psu-epl/plastic-scanner/PCB2/symbol_and_footprints/IC_Analog Devices_ADR03ARZ-REEL7/eec.models/Analog_Devices_-_ADR03ARZ-REEL7.step

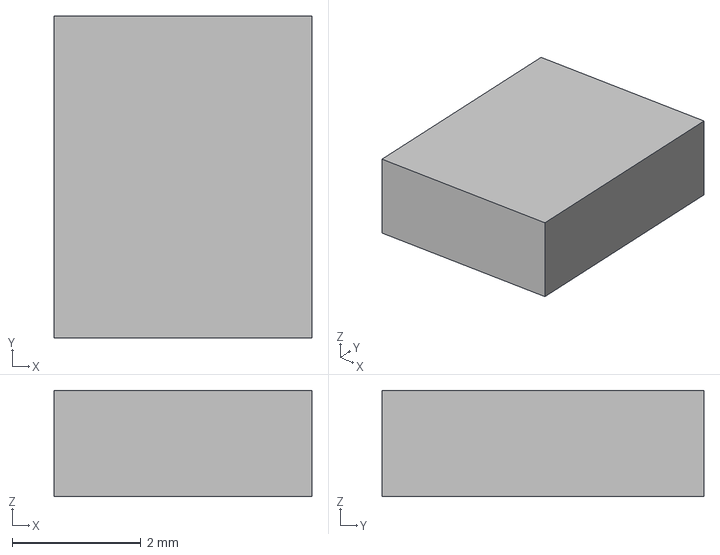
[picture p1: CAD file, 2025-05-15]
PCB2/symbol_and_footprints/IC_Analog Devices_ADR03ARZ-REEL7/eec.models/Analog_Devices_-_ADR03ARZ-REEL7.step
4.00 x 5.00 x 1.65 mm
