psu-epl/plastic-scanner/PCB2/symbol_and_footprints/IC_Nuvoton_NAU7802SGI/eec.models/Nuvoton_-_NAU7802SGI.step

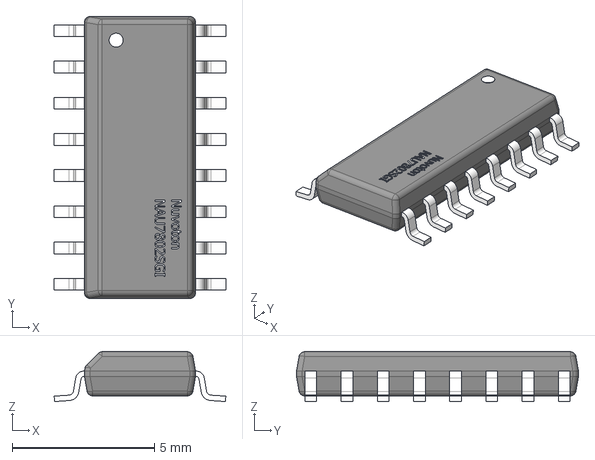
[picture p2: CAD file, 2025-05-15]
PCB2/symbol_and_footprints/IC_Nuvoton_NAU7802SGI/eec.models/Nuvoton_-_NAU7802SGI.step
6.03 x 9.90 x 1.76 mm
