psu-epl/plastic-scanner/PCB2/symbol_and_footprints/IC_Texas Instruments_ADS1256IDBT/eec.models/Texas_Instruments_-_ADS1256IDBT.step

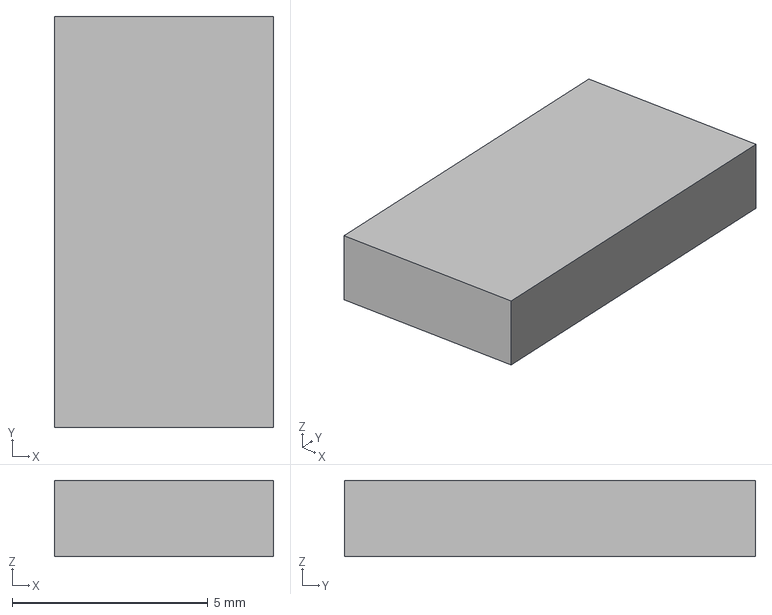
[picture p3: CAD file, 2025-05-15]
PCB2/symbol_and_footprints/IC_Texas Instruments_ADS1256IDBT/eec.models/Texas_Instruments_-_ADS1256IDBT.step
5.60 x 10.5 x 1.95 mm
