psu-epl/plastic-scanner/PCB2/symbol_and_footprints/LP5951MFX-1.8_NOPB/LP5951MFX-1.8_NOPB.step

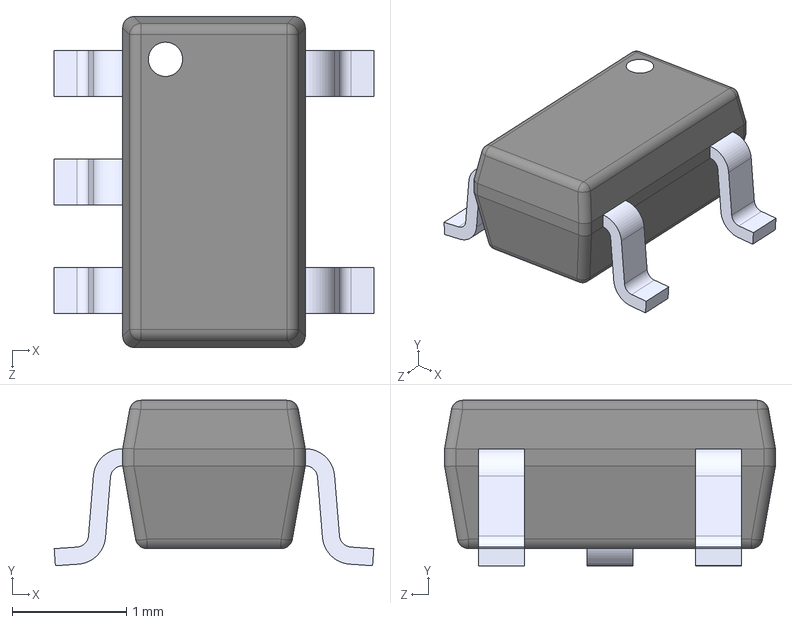
[picture p4: CAD file, 2025-05-15]
PCB2/symbol_and_footprints/LP5951MFX-1.8_NOPB/LP5951MFX-1.8_NOPB.step
2.80 x 1.45 x 2.90 mm
