psu-epl/plastic-scanner/PCB2/symbol_and_footprints/OPA2376AID/OPA2376AID.step

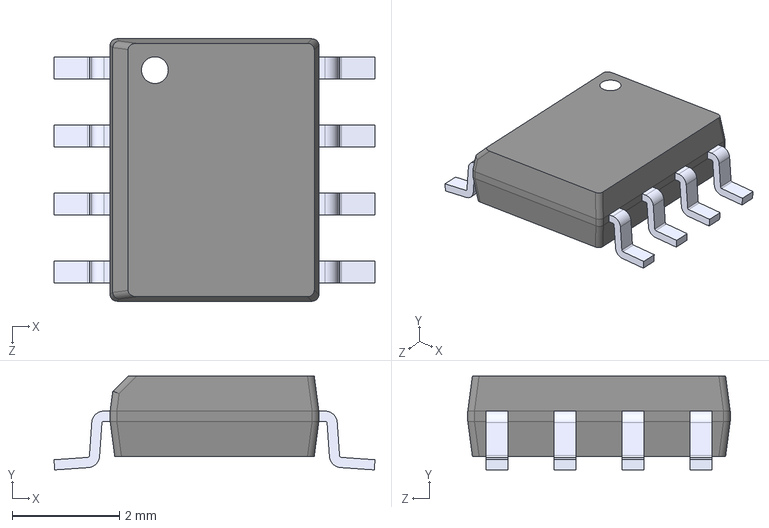
[picture p5: CAD file, 2025-05-15]
PCB2/symbol_and_footprints/OPA2376AID/OPA2376AID.step
5.99 x 1.75 x 4.90 mm
