psu-epl/plastic-scanner/PCB2/symbol_and_footprints/TLC59108IPWR.step

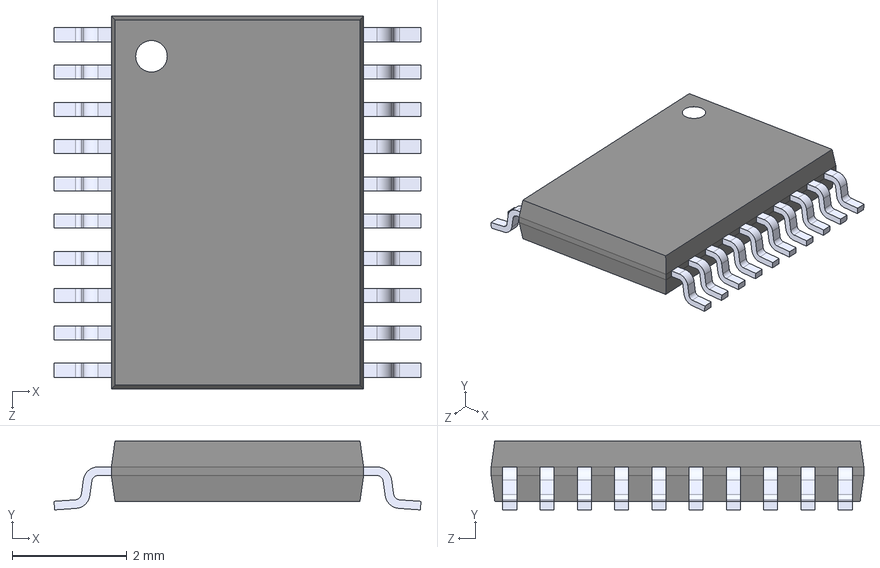
[picture p6: CAD file, 2025-05-15]
PCB2/symbol_and_footprints/TLC59108IPWR.step
6.40 x 1.20 x 6.50 mm
