psu-epl/plastic-scanner/PCB2/PCB KiCad.kicad_pcb

## KiCad design PCB2/PCB KiCad.kicad_pcb (2025-05-23)

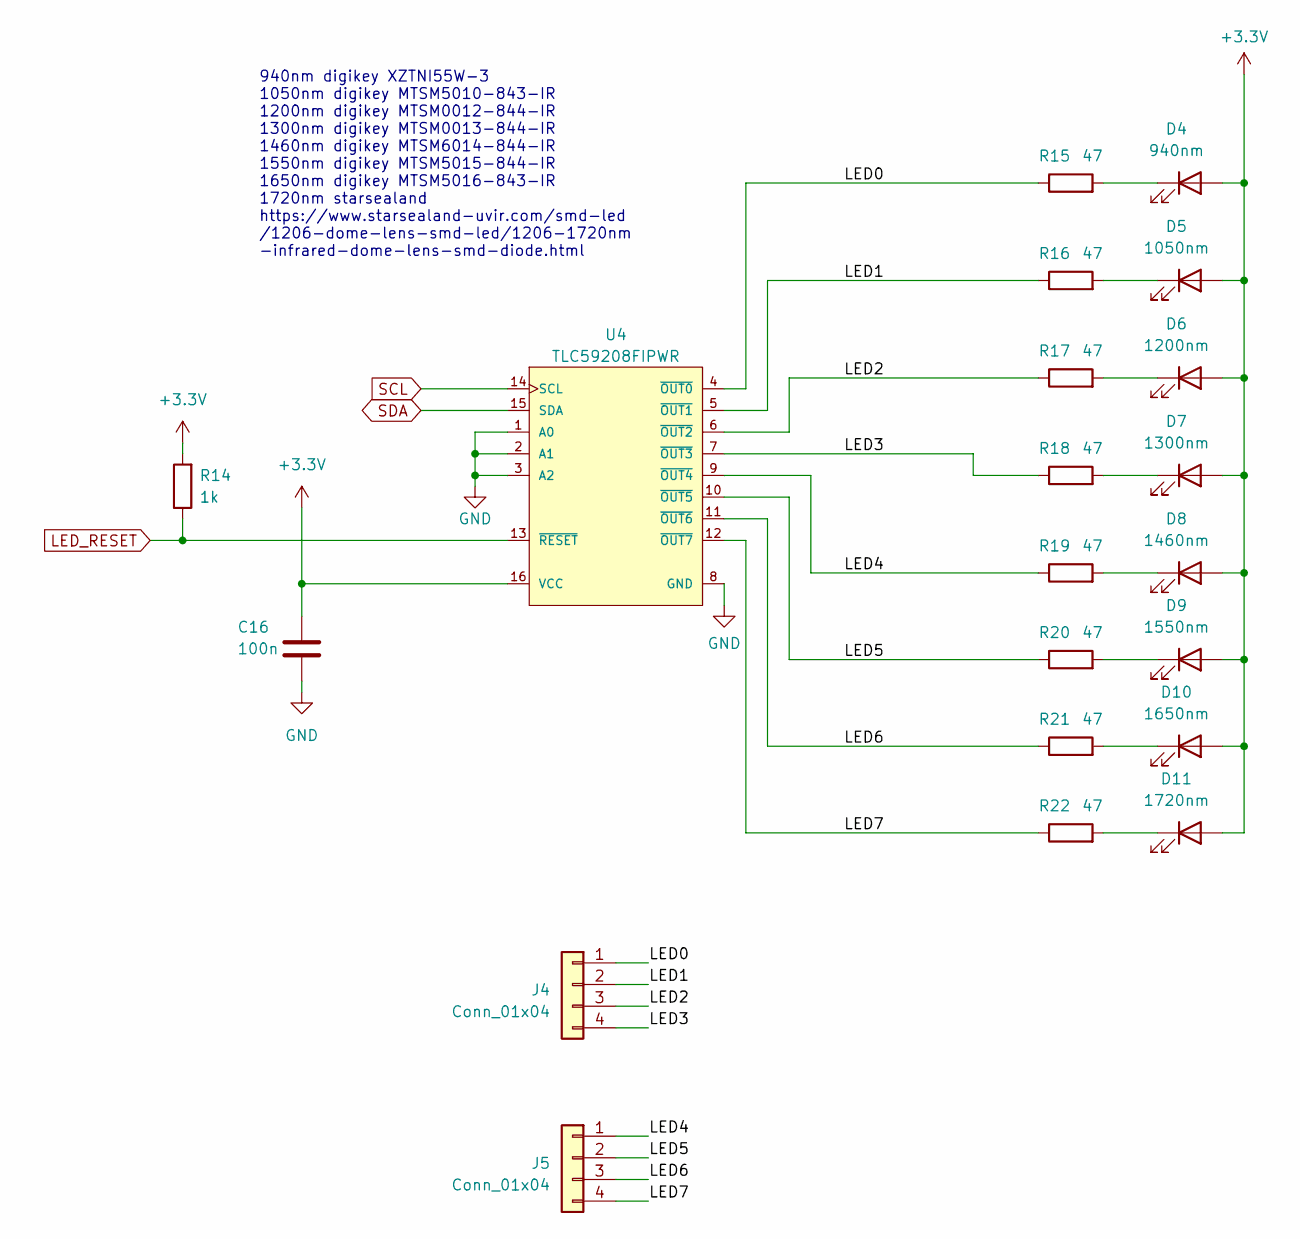
[picture p7: schematic led.kicad_sch, Development Board]

Parts:
C16: 100n; C_0805_2012Metric_Pad1.18x1.45mm_HandSolder
D4: 940nm; LED_1206_3216Metric_Pad1.42x1.75mm_HandSolder
D5: 1050nm; LED_1206_3216Metric_Pad1.42x1.75mm_HandSolder
D6: 1200nm; LED_1206_3216Metric_Pad1.42x1.75mm_HandSolder
D7: 1300nm; LED_1206_3216Metric_Pad1.42x1.75mm_HandSolder
D8: 1460nm; LED_1206_3216Metric_Pad1.42x1.75mm_HandSolder
D9: 1550nm; LED_1206_3216Metric_Pad1.42x1.75mm_HandSolder
D10: 1650nm; LED_1206_3216Metric_Pad1.42x1.75mm_HandSolder
D11: 1720nm; LED_1206_3216Metric_Pad1.42x1.75mm_HandSolder
J4, J5: Conn_01x04; PinSocket_1x04_P2.54mm_Vertical
R14: 1k; R_0805_2012Metric_Pad1.20x1.40mm_HandSolder
R15, R16, R17, R18, R19, R20, R21, R22: 47; R_0805_2012Metric_Pad1.20x1.40mm_HandSolder
U4: TLC59208FIPWR; Texas_Instruments-TLC59208FIPWR-Level_A

Connections:
+3.3V: C16.1, D4.2 (A), D5.2 (A), D6.2 (A), D7.2 (A), D8.2 (A), D9.2 (A), D10.2 (A), D11.2 (A), R14.2, U4.16 (VCC); also elsewhere on the board
/LED/LED0: J4.1, R15.1, U4.4 (~OUT0)
/LED/LED1: J4.2, R16.1, U4.5 (~OUT1)
/LED/LED2: J4.3, R17.1, U4.6 (~OUT2)
/LED/LED3: J4.4, R18.1, U4.7 (~OUT3)
/LED/LED4: J5.1, R19.1, U4.9 (~OUT4)
/LED/LED5: J5.2, R20.1, U4.10 (~OUT5)
/LED/LED6: J5.3, R21.1, U4.11 (~OUT6)
/LED/LED7: J5.4, R22.1, U4.12 (~OUT7)
GND: C16.2, U4.1 (A0), U4.2 (A1), U4.3 (A2), U4.8 (GND); also elsewhere on the board
LED_RESET: R14.1, U4.13 (~RESET); also elsewhere on the board
unnamed: D4.1 (K), R15.2
unnamed: D5.1 (K), R16.2
unnamed: D6.1 (K), R17.2
unnamed: D7.1 (K), R18.2
unnamed: D8.1 (K), R19.2
unnamed: D9.1 (K), R20.2
unnamed: D10.1 (K), R21.2
unnamed: D11.1 (K), R22.2
SCL: U4.14 (SCL); also elsewhere on the board
SDA: U4.15 (SDA); also elsewhere on the board

Notes on the sheet:
940nm digikey XZTNI55W-3 1050nm digikey MTSM5010-843-IR 1200nm digikey MTSM0012-844-IR 1300nm digikey MTSM0013-844-IR 1460nm digikey MTSM6014-844-IR 1550nm digikey MTSM5015-844-IR 1650nm digikey MTSM5016-843-IR 1720nm starsealand https://www.starsealand-uvir.com/smd-led /1206-dome-lens-smd-led/1206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

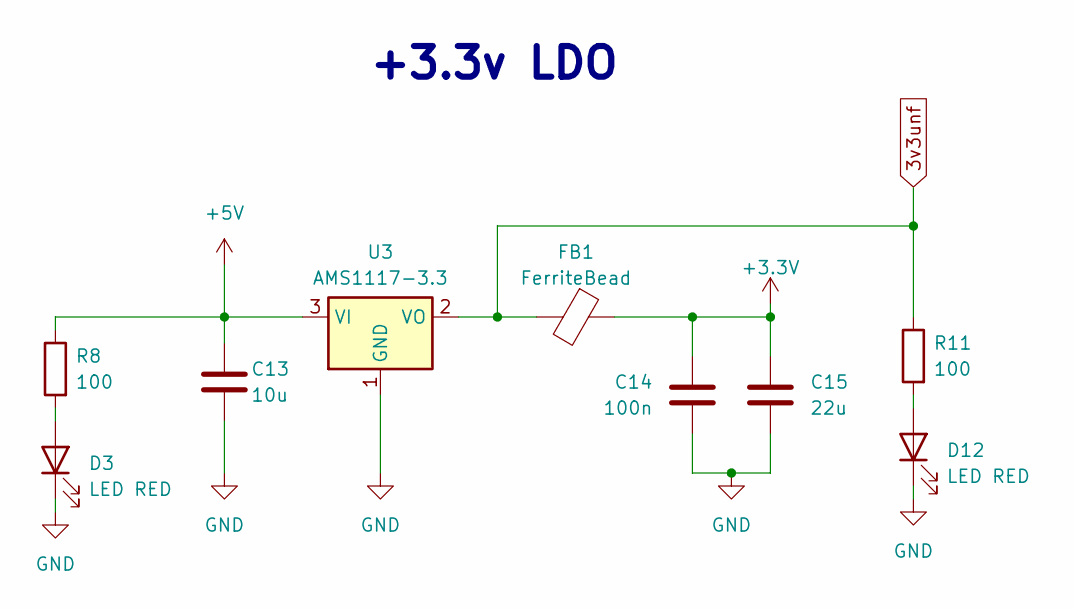
[picture p8: schematic power.kicad_sch, Development Board]

Parts:
C13: 10u; C_0805_2012Metric_Pad1.18x1.45mm_HandSolder
C14: 100n; C_0805_2012Metric_Pad1.18x1.45mm_HandSolder
C15: 22u; C_0805_2012Metric_Pad1.18x1.45mm_HandSolder
D3, D12: LED RED; LED_0805_2012Metric_Pad1.15x1.40mm_HandSolder
FB1: FerriteBead; R_0805_2012Metric_Pad1.20x1.40mm_HandSolder
R8, R11: 100; R_0805_2012Metric_Pad1.20x1.40mm_HandSolder
U3: AMS1117-3.3; SOT-223-3_TabPin2

Connections:
3v3unf: FB1.2, R11.1, U3.2 (VO); also elsewhere on the board
+3.3V: C14.2, C15.1, FB1.1; also elsewhere on the board
+5V: C13.1, R8.1, U3.3 (VI); also elsewhere on the board
GND: C13.2, C14.1, C15.2, D3.1 (K), D12.1 (K), U3.1 (GND); also elsewhere on the board
unnamed: D3.2 (A), R8.2
unnamed: D12.2 (A), R11.2

Notes on the sheet:
+3.3v LDO

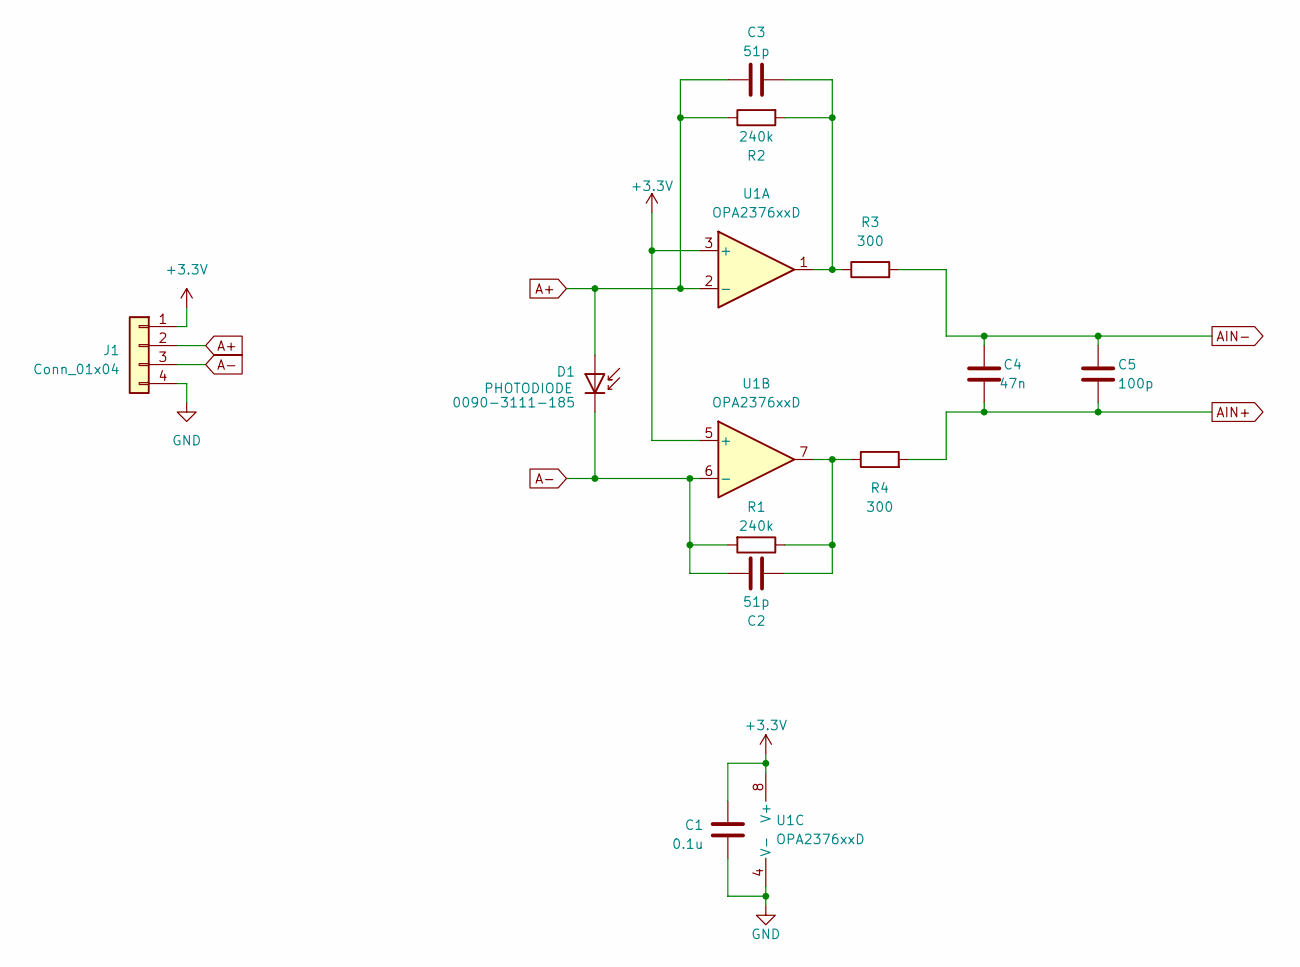
[picture p9: schematic sensor.kicad_sch, Development Board]

Parts:
C1: 0.1u; C_0805_2012Metric_Pad1.18x1.45mm_HandSolder
C2, C3: 51p; C_0805_2012Metric_Pad1.18x1.45mm_HandSolder
C4: 47n; C_0805_2012Metric_Pad1.18x1.45mm_HandSolder
C5: 100p; C_0805_2012Metric_Pad1.18x1.45mm_HandSolder
D1: 0090-3111-185; D_1206_3216Metric_Pad1.42x1.75mm_HandSolder
J1: Conn_01x04; PinSocket_1x04_P2.54mm_Vertical
R1, R2: 240k; R_0805_2012Metric_Pad1.20x1.40mm_HandSolder
R3, R4: 300; R_0805_2012Metric_Pad1.20x1.40mm_HandSolder
U1: OPA2376xxD; SOIC127P599X175-8N

Connections:
+3.3V: C1.2, J1.1, U1.3 (+), U1.5 (+), U1.8 (V+); also elsewhere on the board
A+: C3.1, D1.2 (A), J1.2, R2.1, U1.2 (-)
A-: C2.1, D1.1 (K), J1.3, R1.2, U1.6 (-)
AIN+: C4.1, C5.2, R4.2; also elsewhere on the board
AIN-: C4.2, C5.1, R3.2; also elsewhere on the board
GND: C1.1, J1.4, U1.4 (V-); also elsewhere on the board
unnamed: C2.2, R1.1, R4.1, U1.7
unnamed: C3.2, R2.2, R3.1, U1.1

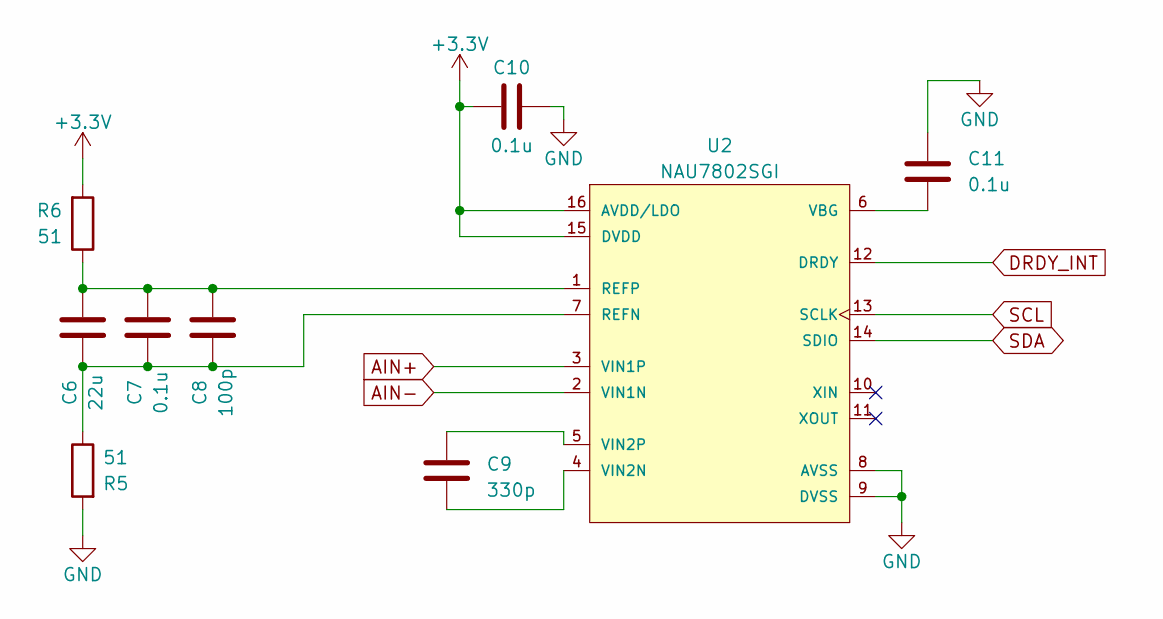
[picture p10: schematic adc.kicad_sch, Development Board]

Parts:
C6: 22u; C_0805_2012Metric_Pad1.18x1.45mm_HandSolder
C7, C10, C11: 0.1u; C_0805_2012Metric_Pad1.18x1.45mm_HandSolder
C8: 100p; C_0805_2012Metric_Pad1.18x1.45mm_HandSolder
C9: 330p; C_0805_2012Metric_Pad1.18x1.45mm_HandSolder
R5, R6: 51; R_0805_2012Metric_Pad1.20x1.40mm_HandSolder
U2: NAU7802SGI; Nuvoton-NAU7802SGI-0-0-0; digikey description IC ADC 24BIT I2C/SRL 16-SOP

Connections:
+3.3V: C10.1, R6.2, U2.15 (DVDD), U2.16 (AVDD/LDO); also elsewhere on the board
AIN+: U2.3 (VIN1P); also elsewhere on the board
AIN-: U2.2 (VIN1N); also elsewhere on the board
DRDY_INT: U2.12 (DRDY); also elsewhere on the board
GND: C10.2, C11.1, R5.2, U2.8 (AVSS), U2.9 (DVSS); also elsewhere on the board
unnamed: C6.1, C7.1, C8.1, R5.1, U2.7 (REFN)
unnamed: C6.2, C7.2, C8.2, R6.1, U2.1 (REFP)
unnamed: C11.2, U2.6 (VBG)
unnamed: C9.2, U2.4 (VIN2N)
unnamed: C9.1, U2.5 (VIN2P)
SCL: U2.13 (SCLK); also elsewhere on the board
SDA: U2.14 (SDIO); also elsewhere on the board

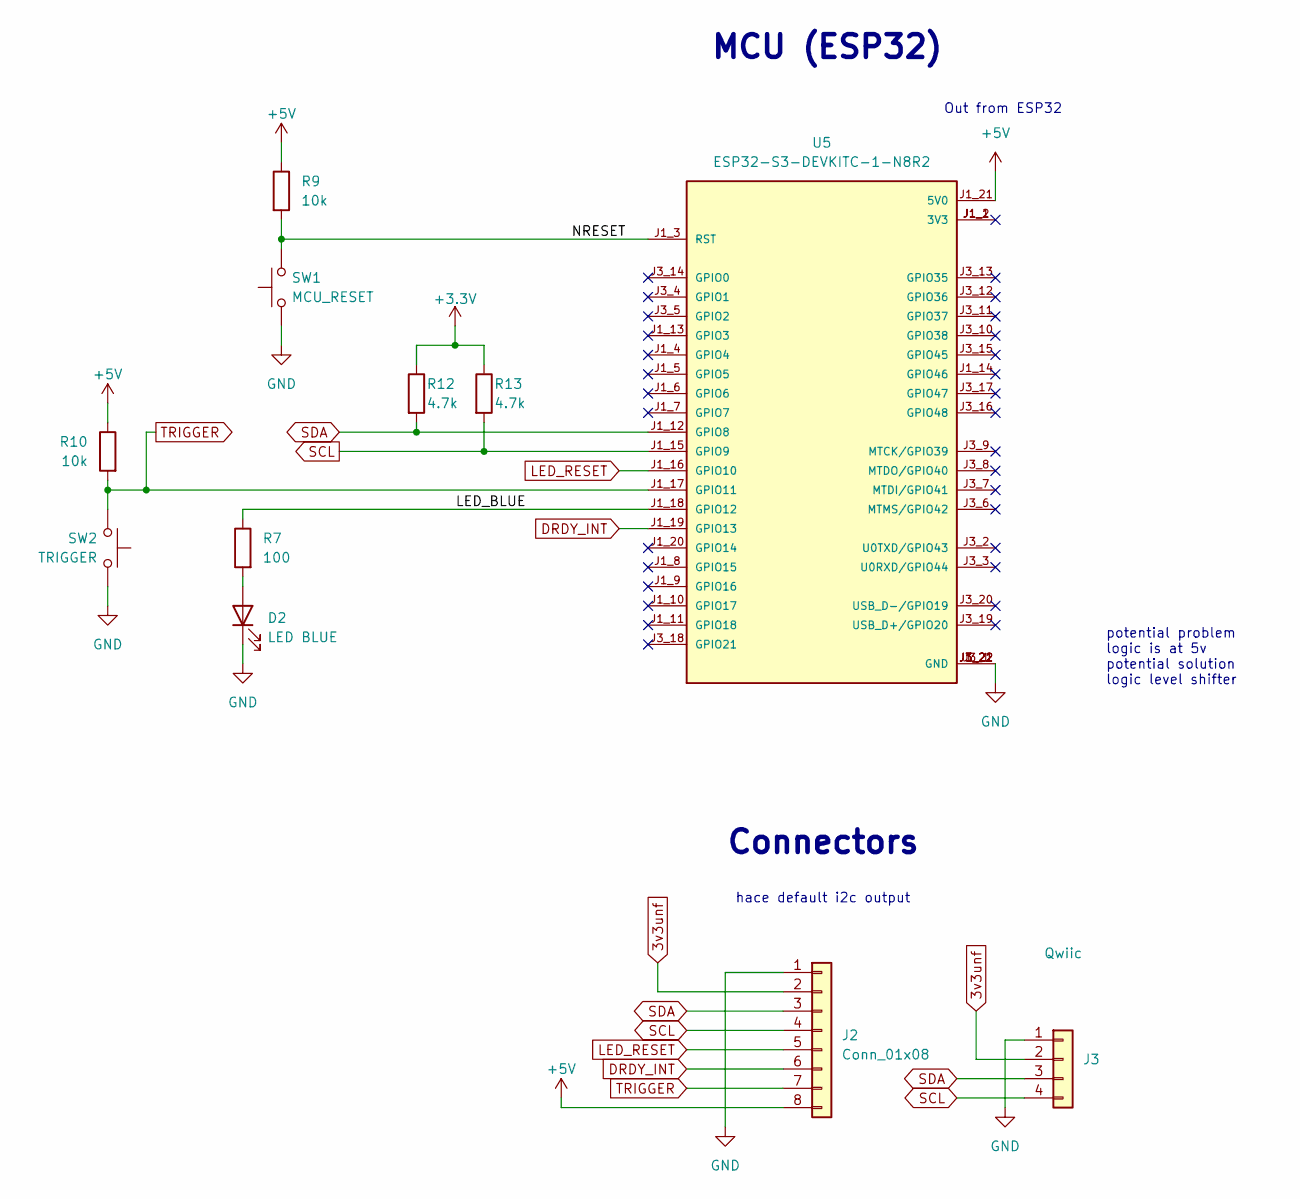
[picture p11: schematic mcu.kicad_sch, Development Board]

Parts:
D2: LED BLUE; LED_0805_2012Metric_Pad1.15x1.40mm_HandSolder
J2: Conn_01x08; PinHeader_1x08_P2.54mm_Vertical
J3: Qwiic; JST_SH_SM04B-SRSS-TB_1x04-1MP_P1.00mm_Horizontal
R7: 100; R_0805_2012Metric_Pad1.20x1.40mm_HandSolder
R9, R10: 10k; R_0805_2012Metric_Pad1.20x1.40mm_HandSolder
R12, R13: 4.7k; R_0805_2012Metric_Pad1.20x1.40mm_HandSolder
SW1: MCU_RESET; SW_PUSH_6mm
SW2: TRIGGER; SW_PUSH_6mm
U5: ESP32-S3-DEVKITC-1-N8R2; XCVR_ESP32-S3-DEVKITC-1-N8R2; PARTREV V1

Connections:
3v3unf: J2.2, J3.2; also elsewhere on the board
+3.3V: R12.1, R13.1; also elsewhere on the board
+5V: J2.8, R9.1, R10.1, U5.J1_21 (5V0); also elsewhere on the board
/MCU + IO/LED_BLUE: R7.1, U5.J1_18 (GPIO12)
/MCU + IO/NRESET: R9.2, SW1.2, U5.J1_3 (RST)
DRDY_INT: J2.6, U5.J1_19 (GPIO13); also elsewhere on the board
GND: D2.1 (K), J2.1, J3.1, SW1.1, SW2.1, U5.J1_22 (GND), U5.J3_1 (GND), U5.J3_21 (GND), U5.J3_22 (GND); also elsewhere on the board
LED_RESET: J2.5, U5.J1_16 (GPIO10); also elsewhere on the board
unnamed: D2.2 (A), R7.2
SCL: J2.4, J3.4, R13.2, U5.J1_15 (GPIO9); also elsewhere on the board
SDA: J2.3, J3.3, R12.2, U5.J1_12 (GPIO8); also elsewhere on the board
TRIGGER: J2.7, R10.2, SW2.2, U5.J1_17 (GPIO11)

Notes on the sheet:
MCU (ESP32)
potential problem logic is at 5v potential solution logic level shifter
Out from ESP32
hace default i2c output
Connectors

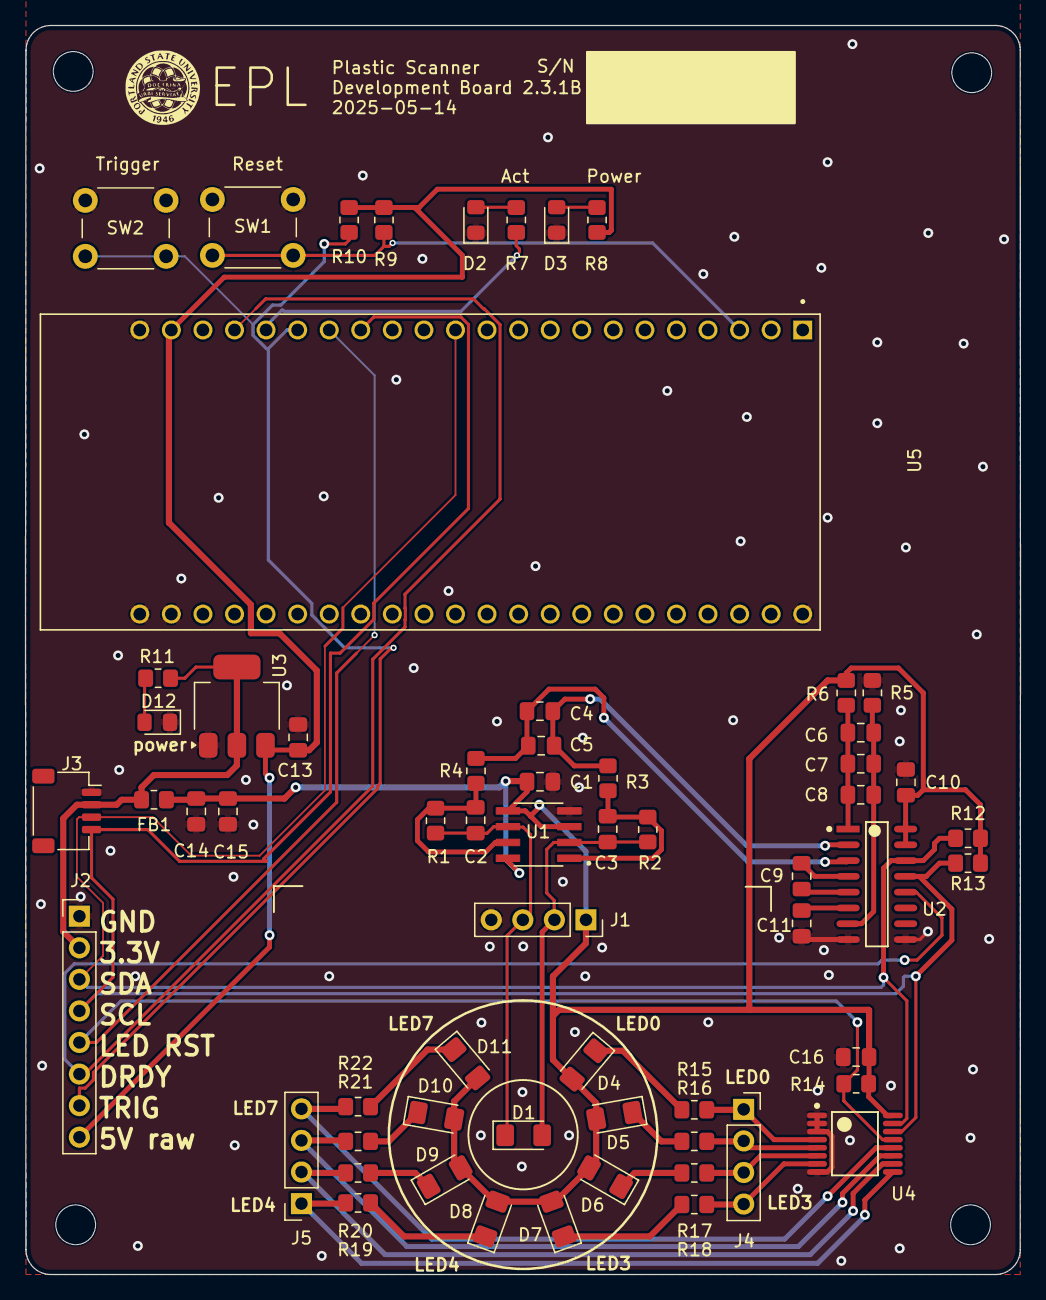
[picture p12: board PCB KiCad.kicad_pcb from above]

Board: 2 copper layers, 80.1 x 100.5 mm, 64 parts (1 on the bottom side), 41 nets.

Other parts of the board:
G1: LOGO
e: MountingHole_3.2mm_M3
