psu-epl/plastic-scanner/(commit log)

2025-03-27 Minor schematic cleanup!
    [PCB KiCad.kicad_pcb, PCB KiCad.kicad_sch, adc.kicad_sch, led.kicad_sch, mcu.kicad_sch, power.kicad_sch, sensor.kicad_sch]
2025-03-27 Giant schematic cleanup to make more sense of the sensor circuit and just clean everything up a bit.
    [PCB KiCad.kicad_pcb, PCB KiCad.kicad_sch, adc.kicad_sch, led.kicad_sch, mcu.kicad_sch, power.kicad_sch, sensor.kicad_sch]
2025-03-27 Relabel LEDs 0 - 7 and put that on the silkscreen for reference.
    [PCB KiCad.kicad_pcb, led.kicad_sch, sensor.kicad_sch]
2025-05-15 PCB version 2 with wifi
    [Analog_Devices_-_ADR03ARZ-REEL7.step, LP5951MFX-1.8_NOPB.step, Nuvoton_-_NAU7802SGI.step, OPA2376AID.step, PCB KiCad.kicad_pcb, PCB KiCad.kicad_sch, TLC59108IPWR.step, Texas_Instruments_-_ADS1256IDBT.step]
2025-05-15 ESP32 footprint
2025-05-15 fixed erc errors added library to path
    [led.kicad_sch, mcu.kicad_sch, power.kicad_sch]
2025-05-15 updated pcb traces
    [PCB KiCad.kicad_pcb]
2025-05-23 added a github barcode and gerbers files in pcb2 folder
    [PCB KiCad.kicad_pcb]
